hasindu2008/PowerAnalysis/other_testbeds/Breaking_Speck/6.postanalysis/key vs traces/matlab/graphs/8.jpg

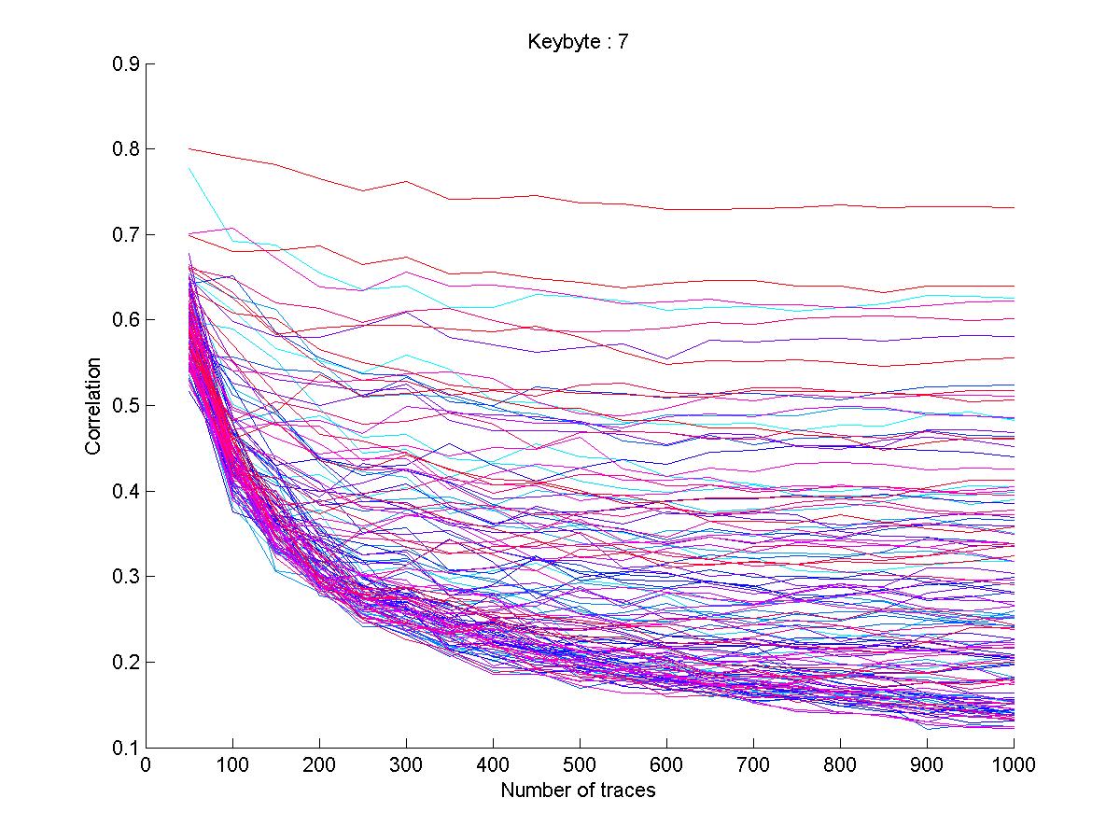
other_testbeds/Breaking_Speck/6.postanalysis/key vs traces/matlab/graphs/8.jpg
