hasindu2008/PowerAnalysis/1.pic_aes/FTDI_USB/version2-beta/slides.pdf

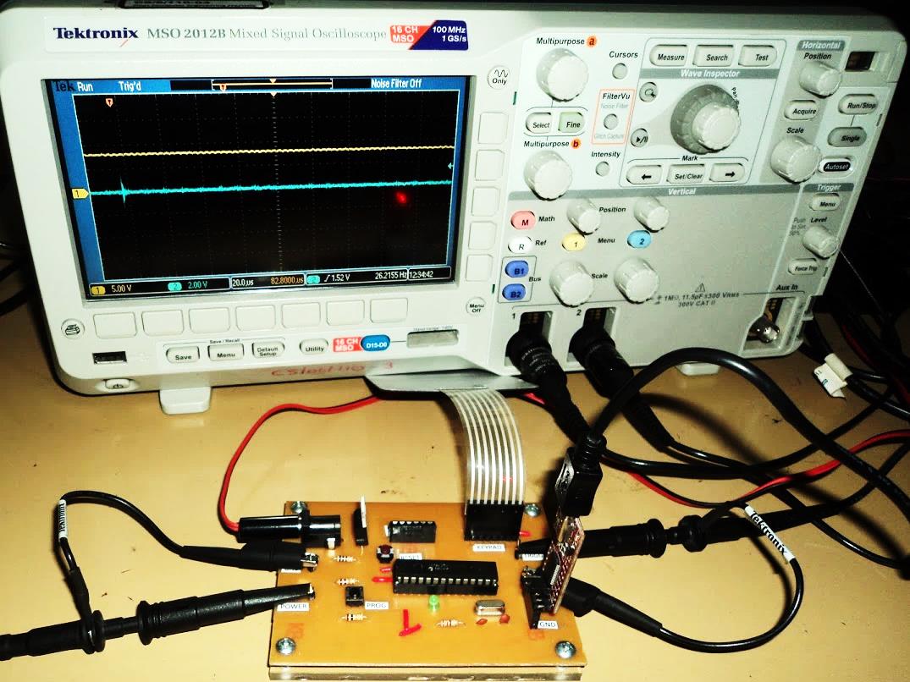
[picture p13: figure]

1

Hasindu Gamaarachchi
Department of Computer Engineering , University of Peradeniya
hasindu2008@gmail.com

Tutorial on Cryptographic and Security Aspects for Information and Communication Systems At ICIAfS 2016

Dec. 18, 2016

# Power analysis

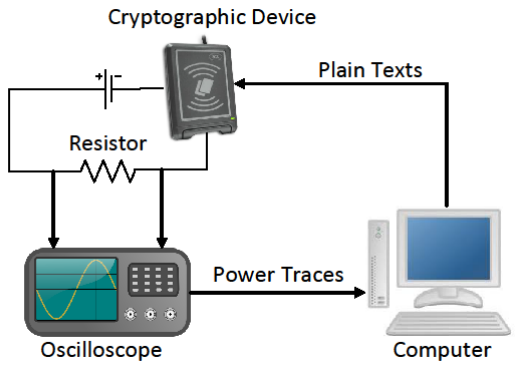
[picture p14: figure]

- Use power consumption data as

the side channel

- First collect power traces
- Then do mathematical analysis
- Simple power analysis
- Differential power analysis
- Correlation power analysis
- Mutual information analysis

2

# Target devices for the attack

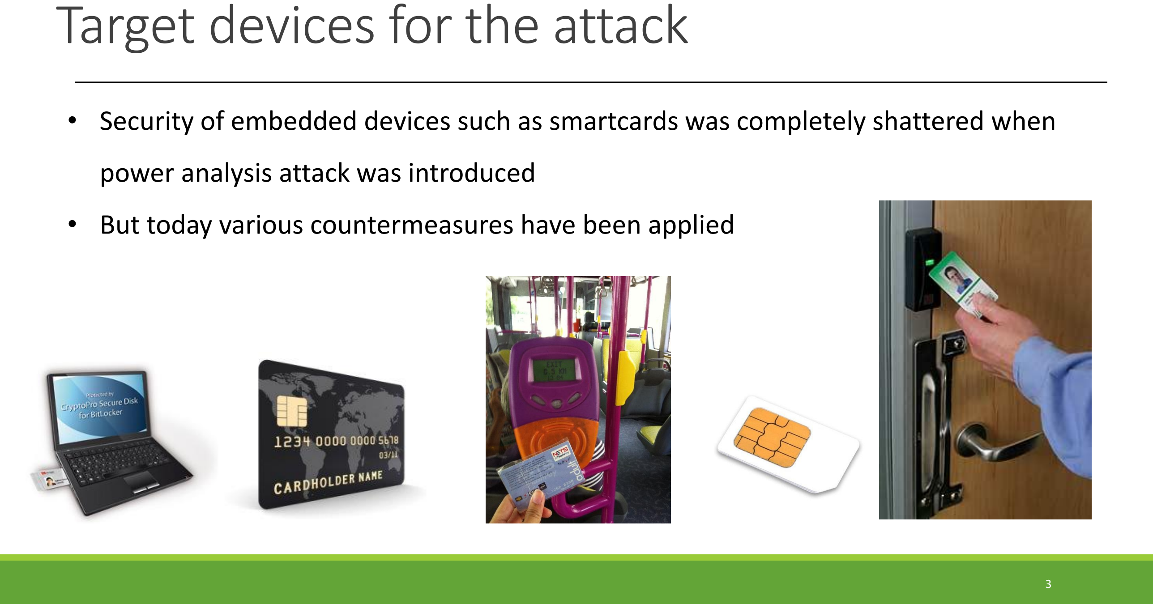
[picture p15: page 3]

- Security of embedded devices such as smartcards was completely shattered when

power analysis attack was introduced

- But today various countermeasures have been applied

3

# Basic Steps of Power Analysis Attack

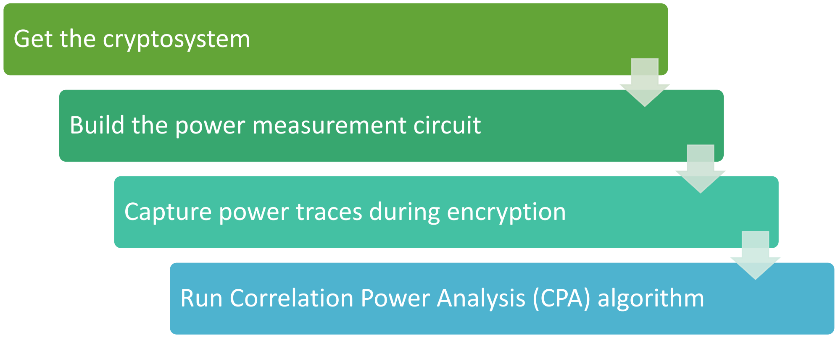
[picture p16: figure]
Get the cryptosystem; Build the power measurement circuit; Capture power traces during encryption

Run Correlation Power Analysis (CPA) algorithm

# Our cryptographic device

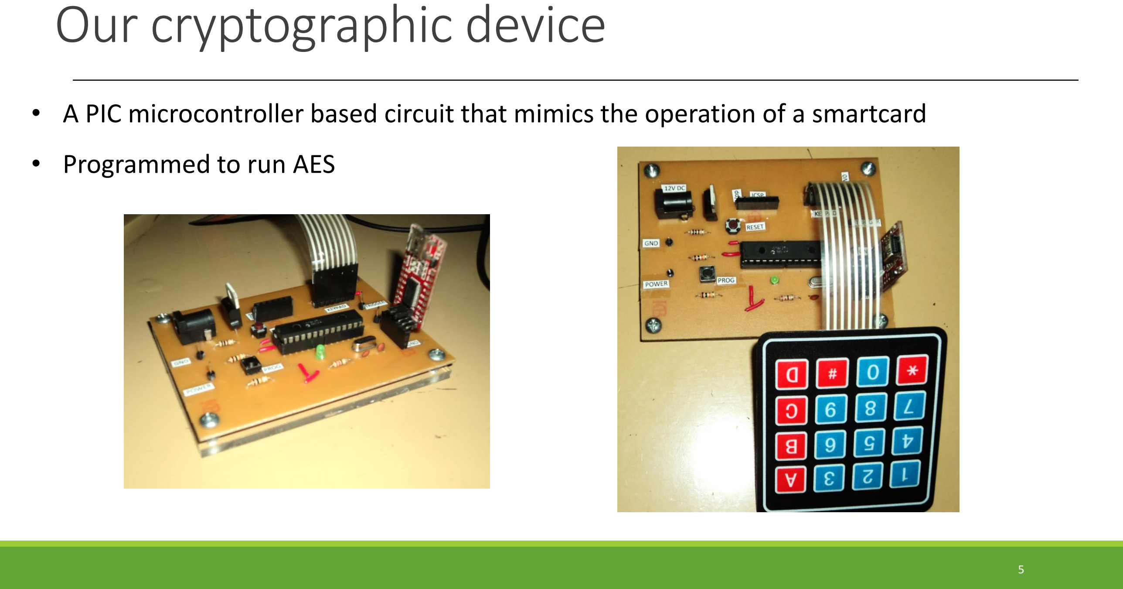
[picture p17: page 5]

5

- A PIC microcontroller based circuit that mimics the operation of a smartcard
- Programmed to run AES

# Basic Steps of Power Analysis Attack

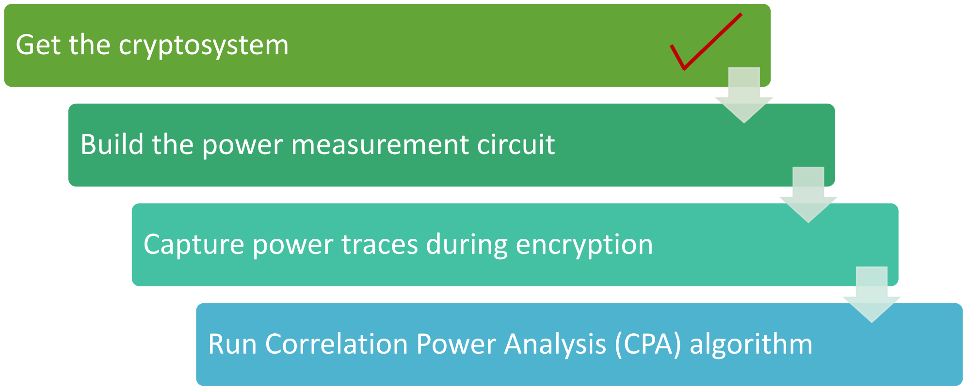
[picture p18: figure]
Get the cryptosystem; Build the power measurement circuit; Capture power traces during encryption

Run Correlation Power Analysis (CPA) algorithm

# Power Measurement

Microcontroller

VDD (Power supply)

Ground

I (current)

## P = VI P = VDD * I

# Power Measurement

Microcontroller

VDD (Power supply)

Ground

I (current)

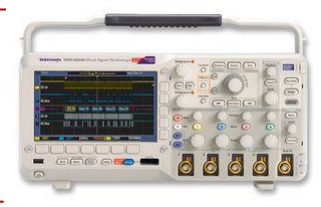
[picture p19: figure]

R (Resistor)

V = I R

# Basic Steps of Power Analysis Attack

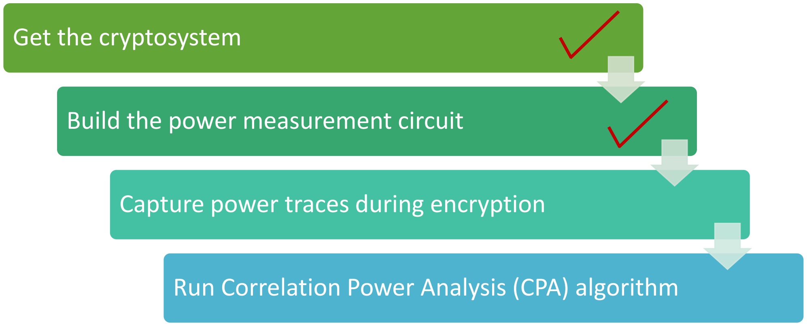
[picture p20: figure]
Get the cryptosystem; Build the power measurement circuit; Capture power traces during encryption

Run Correlation Power Analysis (CPA) algorithm

# Oscilloscope (Tektronix MSO2012B)

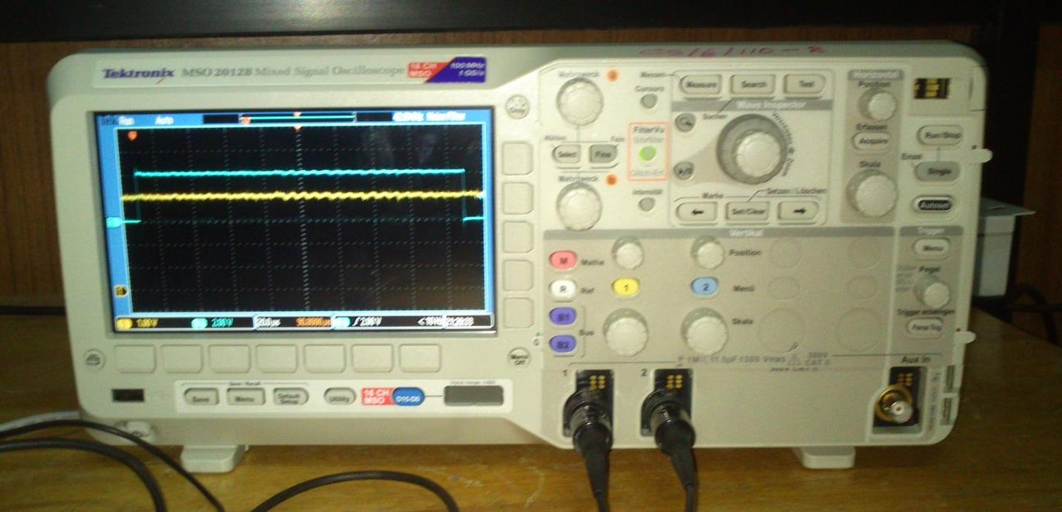
[picture p21: figure]

# Connecting the oscilloscope

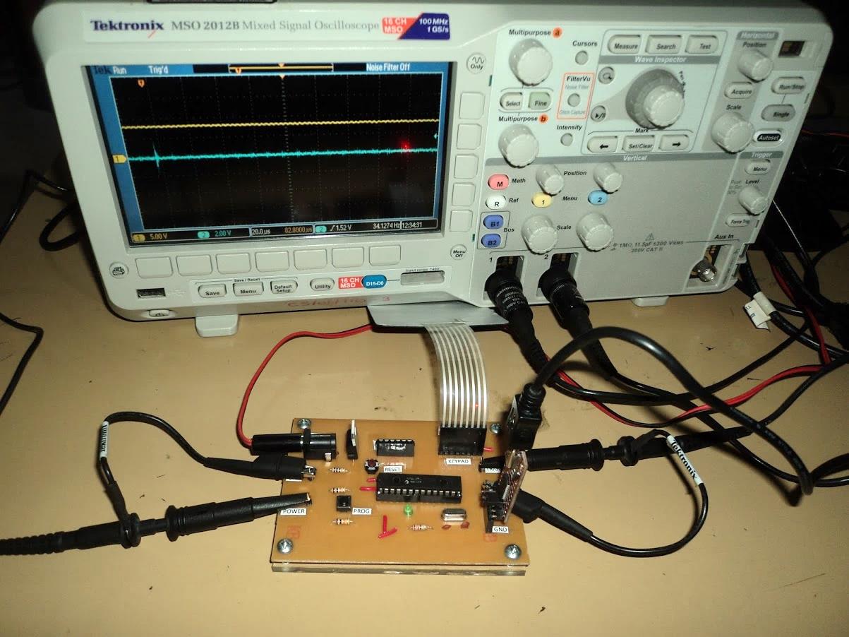
[picture p22: figure]

# A power trace

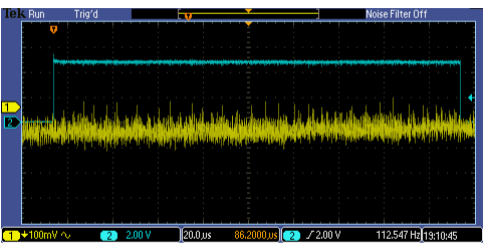
[picture p23: figure]

# Basic Steps of Power Analysis Attack

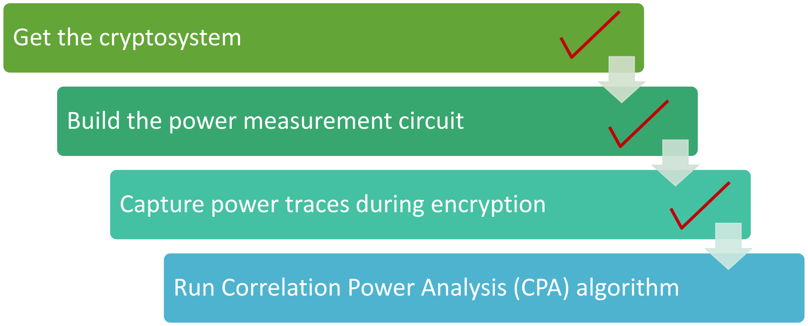
[picture p24: figure]
Get the cryptosystem; Build the power measurement circuit; Capture power traces during encryption

Run Correlation Power Analysis (CPA) algorithm

# CPA Algorithm on CUDA

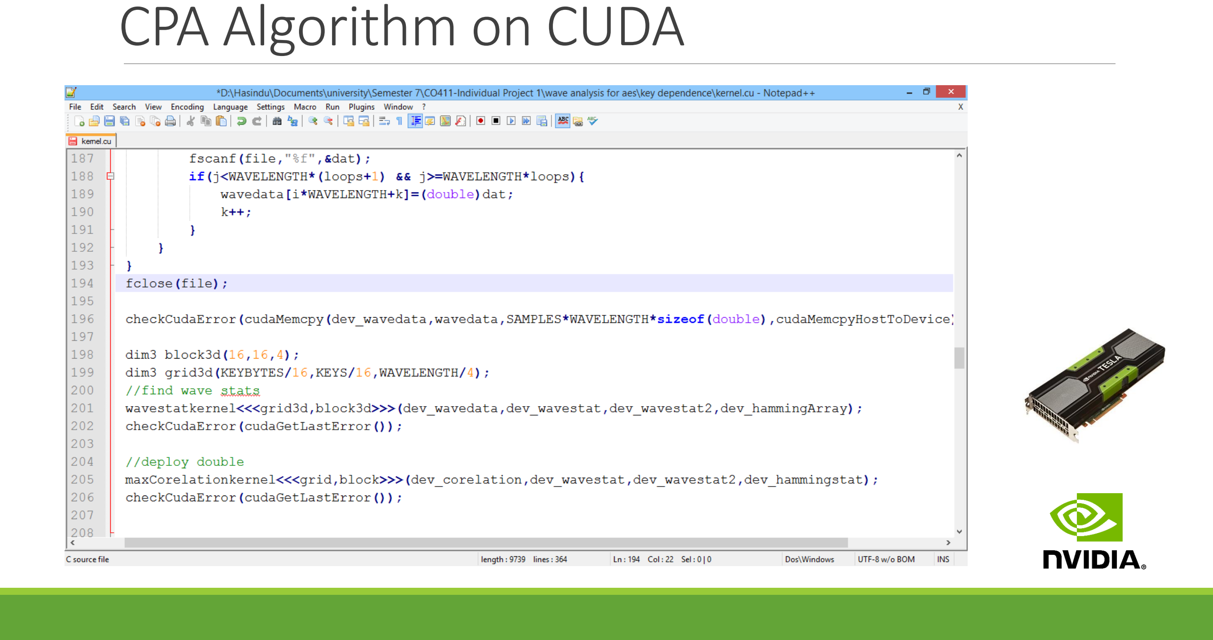
[picture p25: page 14]

# Analysis and the results

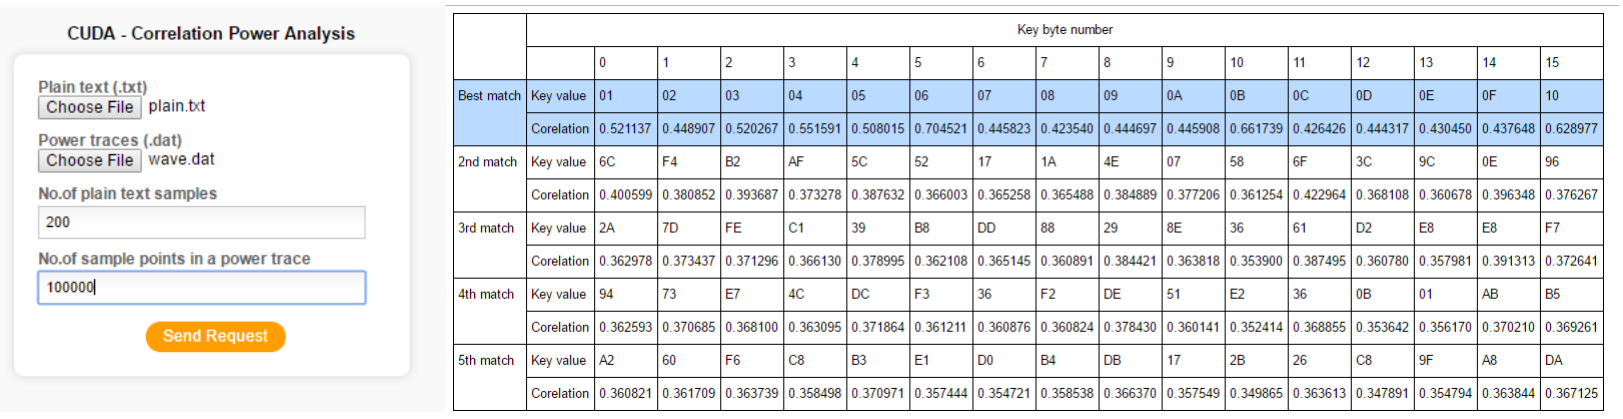
[picture p26: figure]

# Basic Steps of Power Analysis Attack

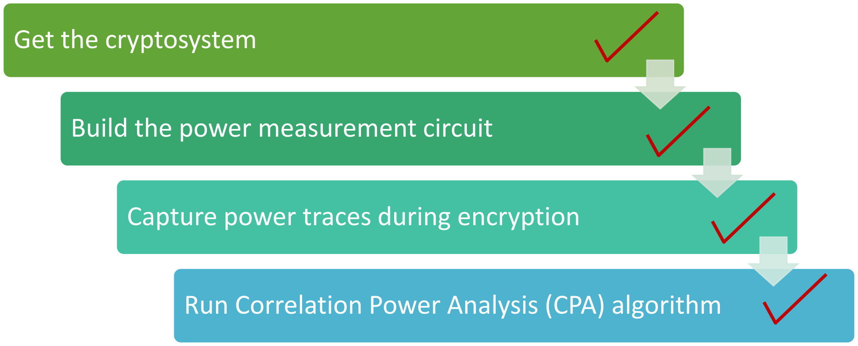
[picture p27: figure]
Get the cryptosystem; Build the power measurement circuit; Capture power traces during encryption

Run Correlation Power Analysis (CPA) algorithm

Theory behind the attack ….

# Computational complexity

- Attack each byte separately

Byte 0; Byte 1; Byte 2; Byte 3; Byte 4; Byte 5; Byte 6; Byte 7; Byte 8; Byte 9; Byte 10; Byte 11; Byte 12; Byte 13; Byte 14; Byte 15

Consists of 16 bytes (let's call byte position)
each byte can take values from 0 to 255 (let’s call subkey) There are 256x16 combinations
Key in AES | 128 bits

# Technical approach

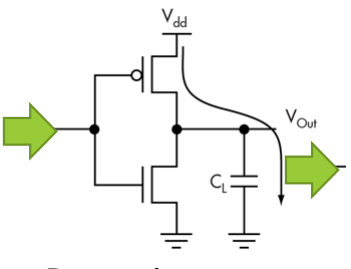
[picture p28: figure]
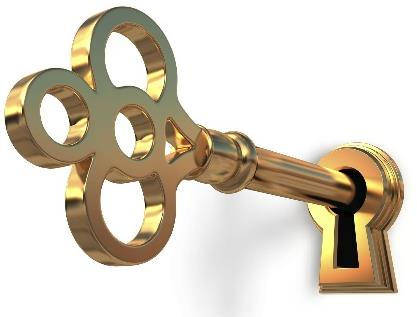
[picture p29: figure]
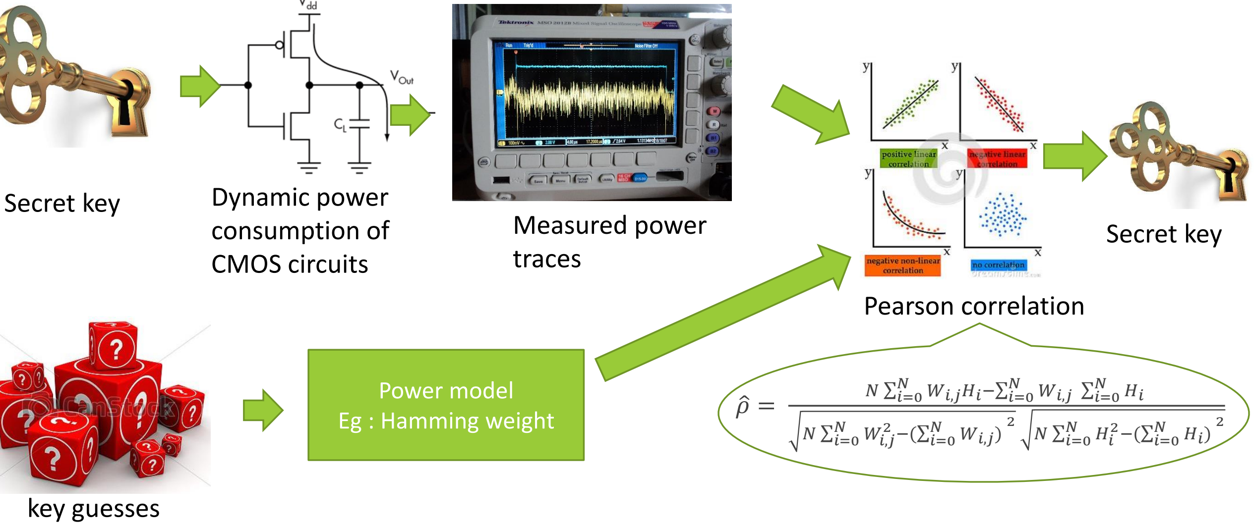
[picture p30: figure]
Power model Eg : Hamming weight; Secret key; Dynamic power; consumption of CMOS circuits; Measured power traces; key guesses; Pearson correlation; N Wi,jHi−σi=0
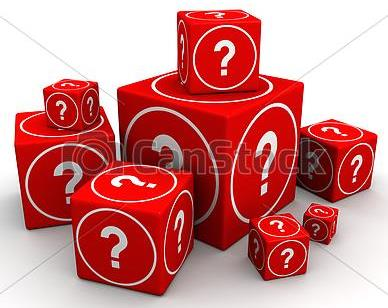
[picture p31: figure]

# Power consumption of CMOS circuits

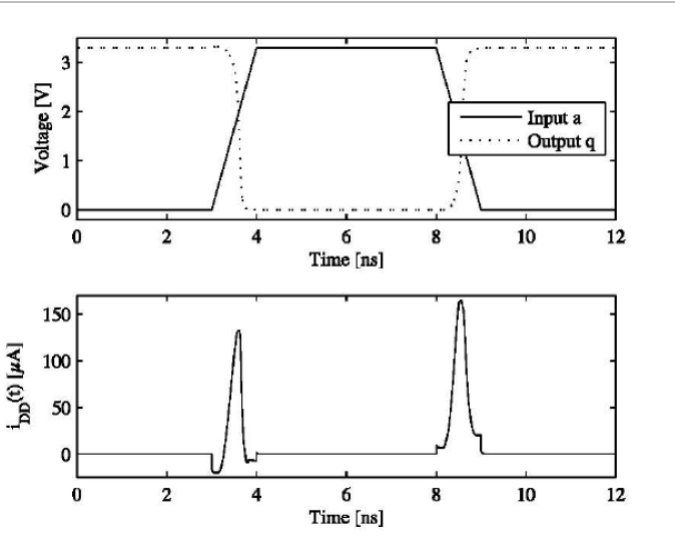
[picture p32: figure]

Power consumption of a NOT gate

# Power model

◦If v0 is the initial value and v1 the next value in a register or memory bus

## Hamming Distance = Sum of set bits (v0 XOR v1)

## ◦If a pre-cleared bus, v0=0

## Hamming Weight = Sum of set bits (v1)

# Selection function for AES

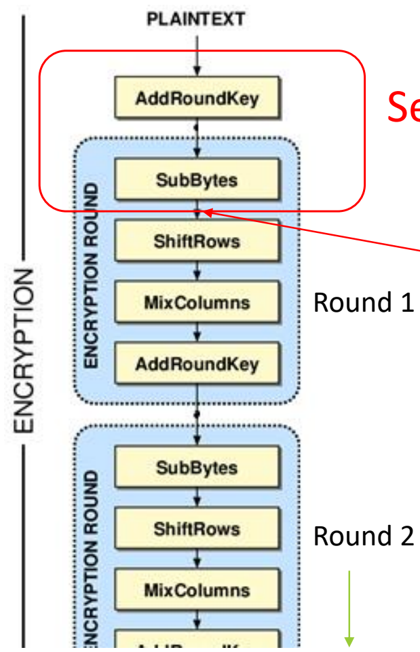
[picture p33: figure]
Round 1; Round 2

Selection function

Intermediate value

# Statistical comparison in CPA

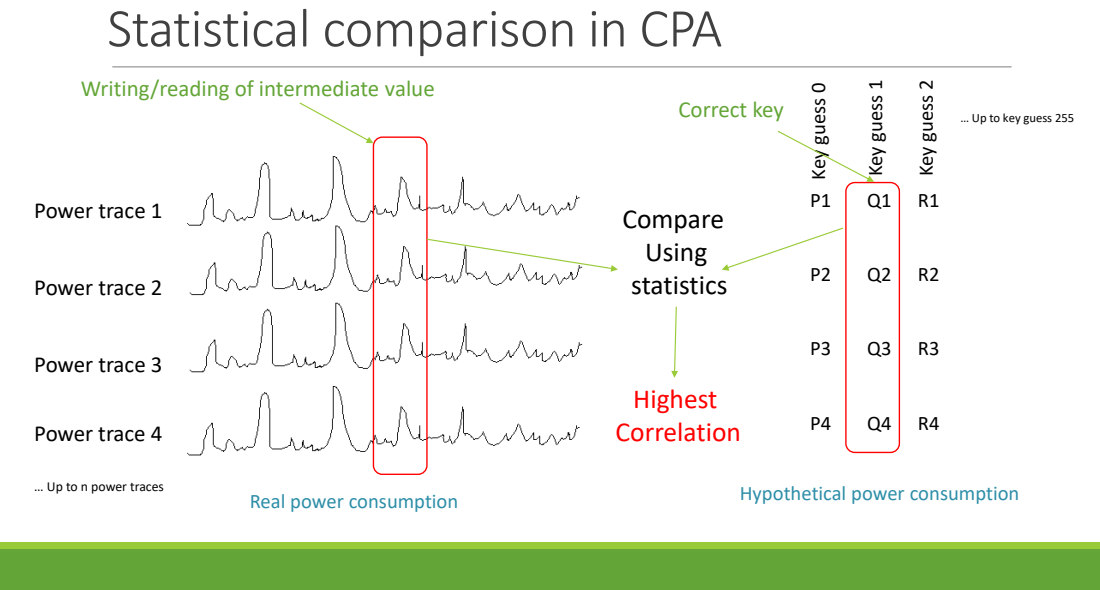
[picture p34: page 23]

Writing/reading of intermediate value

… Up to key guess 255

… Up to n power traces

# Statistical analysis

We use Pearson correlation

ρ

ො

=

N σi=0

N Wi,jHi−σi=0

N Wi,j σi=0

N Hi

N σi=0

N Wi,j

2 −(σi=0

N Wi,j
)

2
N σi=0

N Hi

2−(σi=0

N Hi
)

2

# Correlation vs time for a wrong key guess

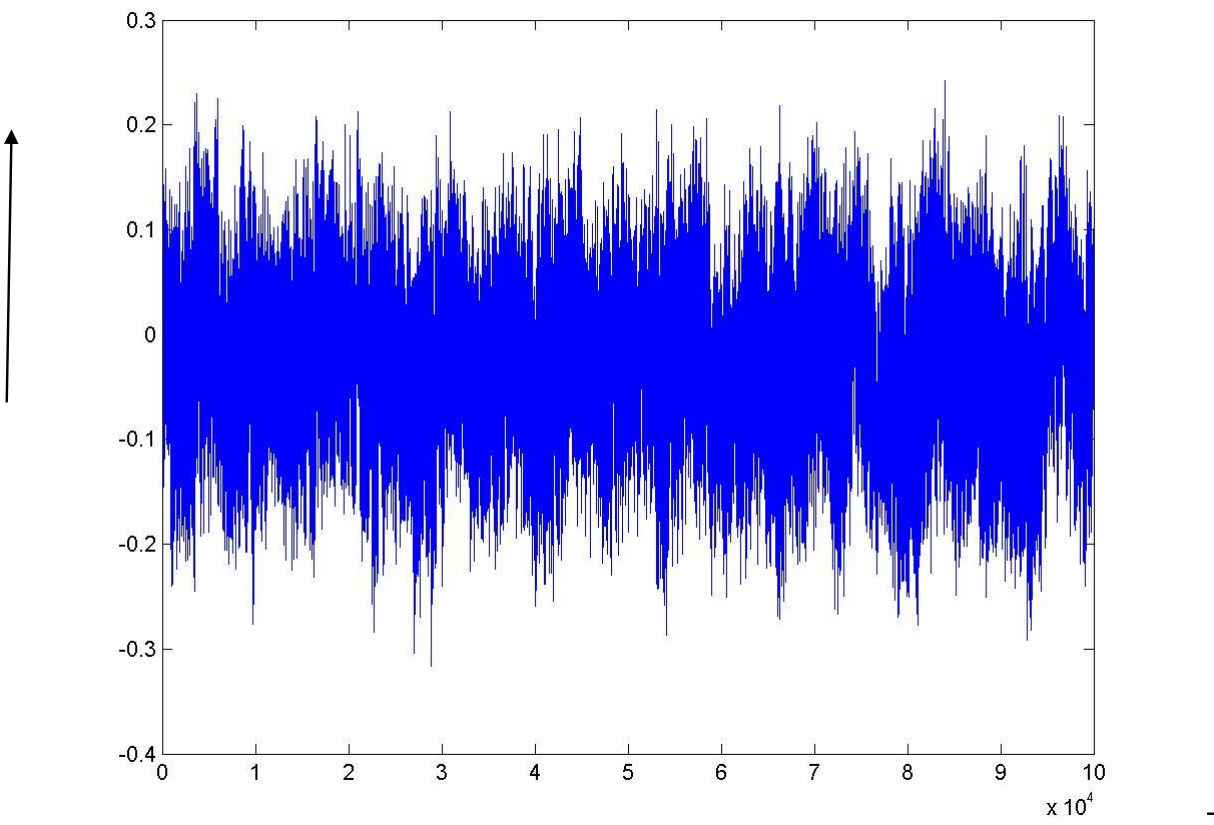
[picture p35: figure]

time

Correlation coefficient

# Correlation vs time for the correct key guess

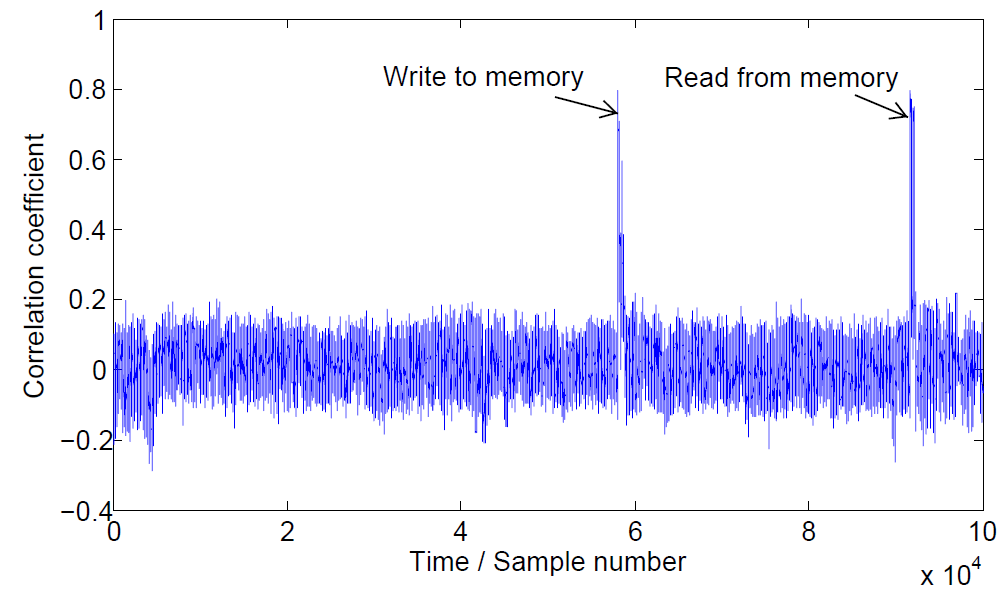
[picture p36: figure]

# Number of traces necessary

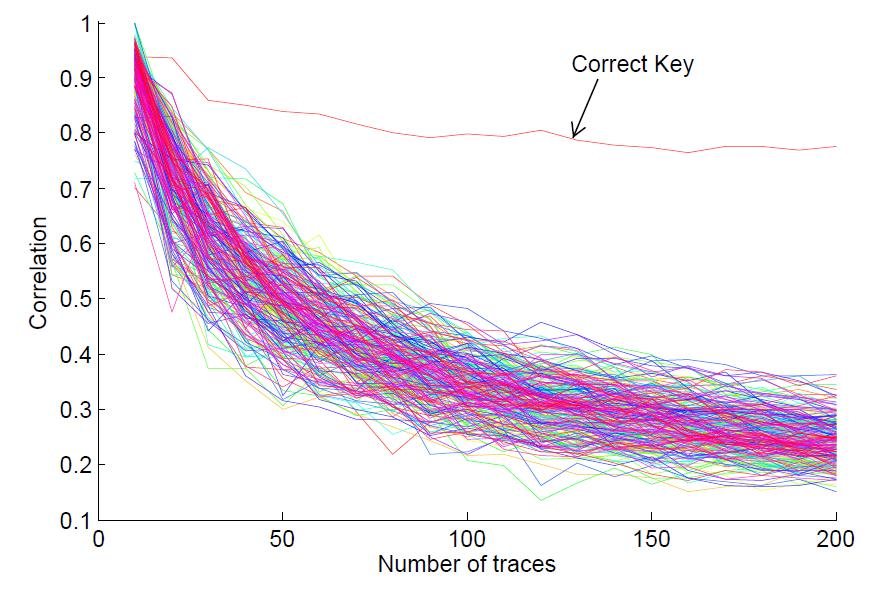
[picture p37: figure]

# For more info

Paper :

Hasindu Gamaarachchi, Harsha Ganegoda and Roshan Ragel, "The A to Z of Building a Testbed for Power Analysis Attacks", 10th IEEE International Conference on Industrial and Information Systems 2015 (ICIIS)

Source codes :

https://github.com/hasindu2008/PowerAnalysis

# More Info

Download slides from :
https://tesla.ce.pdn.ac.lk/iciafs/cpa.pdf

Online power analysis program : https://tesla.ce.pdn.ac.lk/cuda/cpa.php

# Questions?

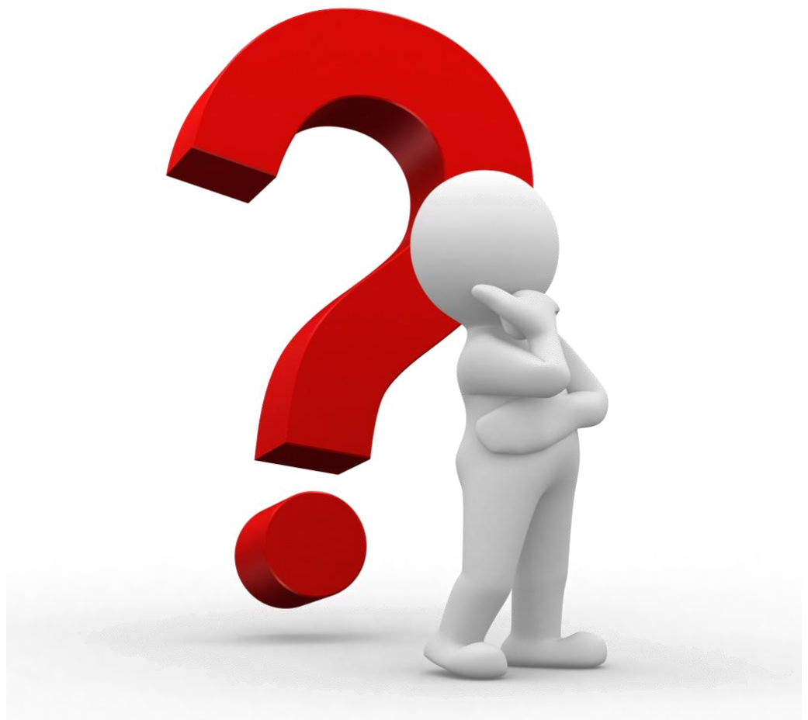
[picture p38: figure]

Contact :
hasindu2008@gmail.com
