hasindu2008/PowerAnalysis/3.collect_power/version2_beta/sample_output/firstwave.jpg

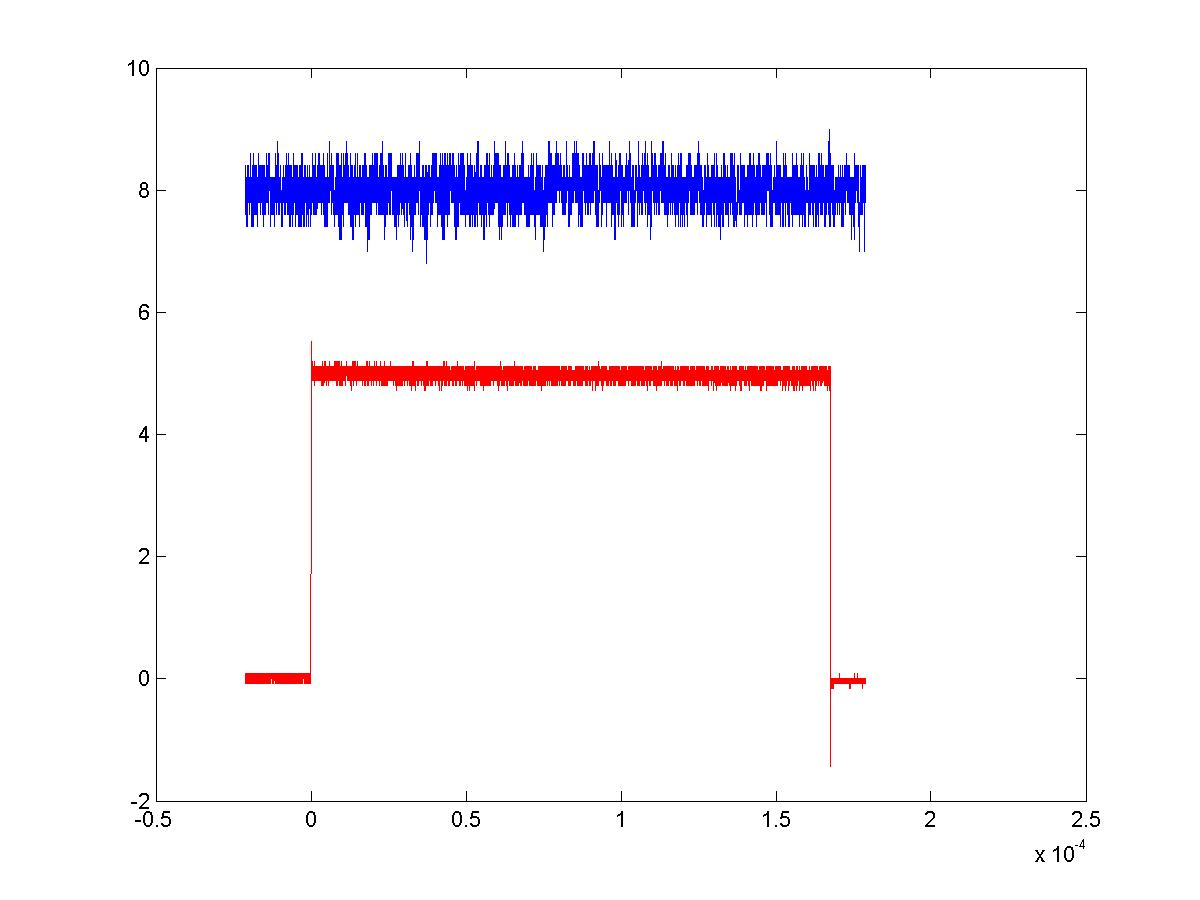
3.collect_power/version2_beta/sample_output/firstwave.jpg
