hasindu2008/PowerAnalysis/(list of files, drawings)

Other design files:
1.pic_aes/FTDI_USB/version2-beta/Preteus_PCB/barrel_jack.pdsprj
1.pic_aes/FTDI_USB/version2-beta/Preteus_PCB/pcb_design_keypad2.pdsprj
1.pic_aes/FTDI_USB/version2-beta/Preteus_PCB/pcb_design_keypad3.pdsprj
1.pic_aes/FTDI_USB/version2-beta/Preteus_PCB/pcb_design_keypad.pdsprj
