hasindu2008/PowerAnalysis/(commit log)

2018-06-07 version 2 beta files for testbed
    [barrel_jack.pdsprj, pcb_design_keypad.pdsprj, pcb_design_keypad2.pdsprj, pcb_design_keypad3.pdsprj]
2018-10-21 added the kpd.c which was missing
    [kpd.c]
